RobMeades/watchdog/README.md

The files in this repo are the source files for the watchdog project, details of which can be found here:

https://www.meades.org/misc/watchdog/watchdog.html
