RobMeades/watchdog/blender/README.md

# Introduction
Here are the 3D-printed parts of the watchdog, based on the marvellous [Wallace and Gromit](https://www.thingiverse.com/thing:1852021) model from [reddadsteve](https://www.thingiverse.com/reddadsteve/designs) on [Thingiverse](https://www.thingiverse.com/).  As with the original, all parts are designed to be printed on an FDM printer such as the [Prusa MK4S](https://www.prusa3d.com/product/original-prusa-mk4s-3d-printer-5/), though the parts here are three times larger and rather more complex given the mechanisation.

# Printing Guidelines
I printed all parts except for the two cog wheels in ASA: all of the body parts (body, torso, collar, face and neck) in natural ASA, the ears, nose and black eyes in black ASA.  The white eyes were printed in natural ASA and painted gloss white afterwards.  The board tray can be printed in any colour.  0.2&nbsp;mm print resolution with 10% in-fill is fine, brims and supports everywhere; these are generally large/complex parts.  I used ASA for UV safety, with which you will likely need glue-stick applied to the heat-bed unless you have a heated chamber (I applied glue-stick and also heated the entire room where the printer is housed to 40&nbsp;C for a few days with a space heater), but you could equally well use PLA if you were less concerned about UV safety.

For hardness, the two cog wheels were printed in polycarbonate at 0.2&nbsp;mm print resolution but with 25% in-fill: ASA is bad enough to print, polycarbonate is even worse but the two cog wheels are quite small so I got away with it; no supports but brims and a whole load of glue stick required.  Likely it is not actually critical to use polycarbonate: if you don't have any then you might use ASA for the cog wheels also.

Be careful when removing the support material, particularly around the back of the collar where the cable outlet is quite delicate, and in the nose, where there are deliberate steps in the front surface of the nose that you don't want to remove by accident (but you _do_ want to _remove_ all of the support material to avoid damaging the camera module).  Removing the support material from the sinuous holes behind the eyes is a b\*gger: I found that a judiciously bent knitting needle did the trick.  The in-fill of the M5 and M2 tap holes should be removable without issue and the in-fill of the holes for the 1.5&nbsp;mm brass bar, used for the electrical limit contacts, should come out with the aid of a pin.

# Assembly Instructions
See https://www.meades.org/misc/watchdog/watchdog.html#assembly.
