RobMeades/watchdog/software/play.png

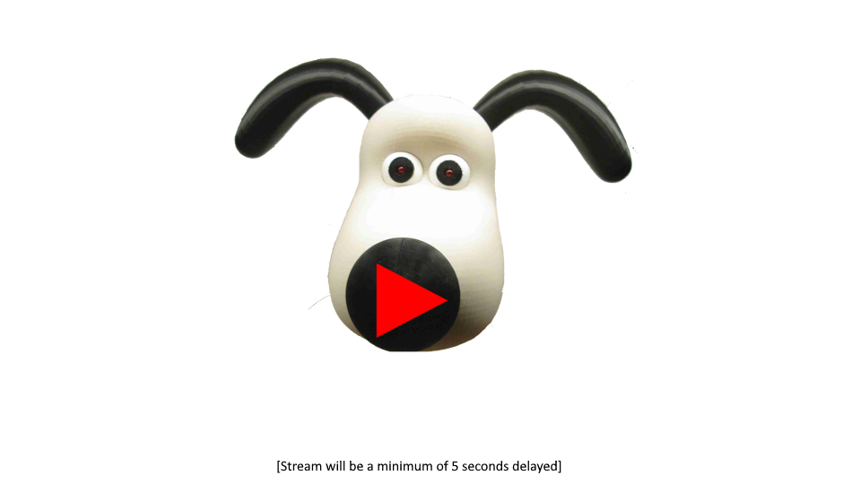
software/play.png
