RobMeades/watchdog/gearotic/pinion.stl

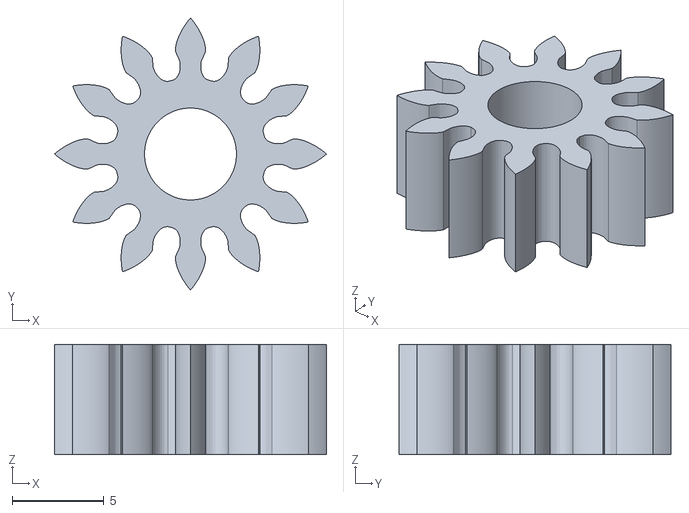
[picture p2: CAD file, 2024-11-27]
gearotic/pinion.stl
14.8 x 14.8 x 6.00
