RobMeades/watchdog/gearotic/wheel.stl

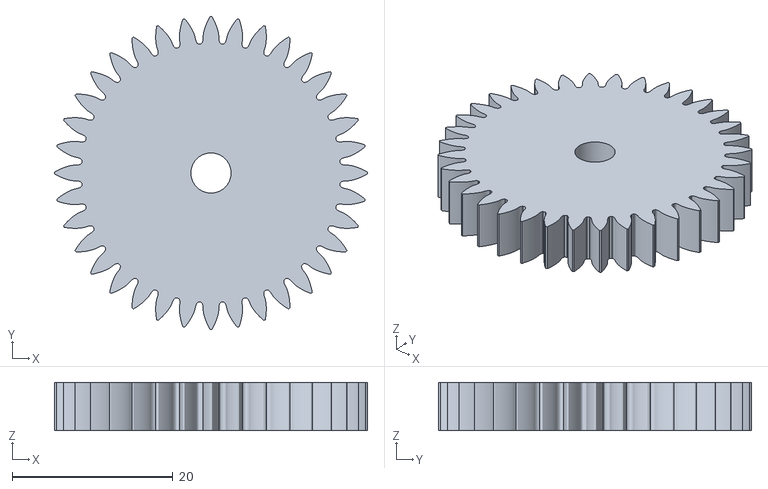
[picture p3: CAD file, 2024-11-27]
gearotic/wheel.stl
39.0 x 39.0 x 6.00
