RobMeades/watchdog/software/w_motor.h

/*
 * Copyright 2025 Rob Meades
 *
 * Licensed under the Apache License, Version 2.0 (the "License");
 * you may not use this file except in compliance with the License.
 * You may obtain a copy of the License at
 *
 * http://www.apache.org/licenses/LICENSE-2.0
 *
 * Unless required by applicable law or agreed to in writing, software
 * distributed under the License is distributed on an "AS IS" BASIS,
 * WITHOUT WARRANTIES OR CONDITIONS OF ANY KIND, either express or implied.
 * See the License for the specific language governing permissions and
 * limitations under the License.
 */

#ifndef _W_MOTOR_H_
#define _W_MOTOR_H_

// This API is dependent on std::string.
#include <string>

/** @file
 * @brief The motor API for the watchdog application; this API is
 * thread-safe.
 */

/* ----------------------------------------------------------------
 * COMPILE-TIME MACROS
 * -------------------------------------------------------------- */

#ifndef W_MOTOR_ROTATE_MAX_STEPS
/** A hard-coded safety limit on the range of rotational movement.
 */
# define W_MOTOR_ROTATE_MAX_STEPS 600
#endif

#ifndef W_MOTOR_VERTICAL_MAX_STEPS
/** A hard-coded safety limit on the range of vertical movement.
 */
# define W_MOTOR_VERTICAL_MAX_STEPS 650
#endif

#ifndef W_MOTOR_ROTATE_DIRECTION_SENSE
/** The direction that a "1" on the rotate motor's direction
 * pin causes the motor to move: -1 since a -1 on the rotate
 * motors direction pin causes it to move towards the maximum,
 * which is W_GPIO_PIN_INPUT_LOOK_RIGHT_LIMIT (otherwise it would
 * need to be 1).
 */
# define W_MOTOR_ROTATE_DIRECTION_SENSE -1
#endif

#ifndef W_MOTOR_VERTICAL_DIRECTION_SENSE
/** The direction that a "1" on the vertical motor's direction
 * pin causes the motor to move: -1 since a -1 on the vertical
 * motors direction pin causes it to move towards the maximum,
 * which is W_GPIO_PIN_INPUT_LOOK_UP_LIMIT (otherwise it would
 * need to be 1).
 */
# define W_MOTOR_VERTICAL_DIRECTION_SENSE -1
#endif

#ifndef W_MOTOR_DIRECTION_WAIT_MS
/** The pause between setting the direction that a step is to
 * take and requesting the step.
 */
# define W_MOTOR_DIRECTION_WAIT_MS 1
#endif

#ifndef W_MOTOR_STEP_WAIT_MS
/** The pause between setting a step pin output low and raising it
 * high again; also the pause between a pin being high and
 * letting it drop again.
 */
# define W_MOTOR_STEP_WAIT_MS 1
#endif

#ifndef W_MOTOR_LIMIT_MARGIN_STEPS
/** How many steps to stay clear of the limit switches in normal
 * operation.
 */
# define W_MOTOR_LIMIT_MARGIN_STEPS 50
#endif

#ifndef W_MOTOR_CALIBRATE_ONE_CALIBRATE_ALL
/** Normally, when a motor is uncalibrated it can be calibrated
 * and the calibration of the other motor is unaffected.  However,
 * it can also be that jarring during the calibration process,
 * which involves hitting the end-stops, cause the calibration of
 * one motor to adversly affect the calibration or the position
 * of the other; set this to true and if one motor falls out of
 * calibration _both_ motors will be calibrated.
 */
# define W_MOTOR_CALIBRATE_ONE_CALIBRATE_ALL true
#endif

/* ----------------------------------------------------------------
 * TYPES
 * -------------------------------------------------------------- */

/** The motor types; values are important as they are the index
 * to that motor in gMotor[].  The motors are calibrated in this
 * order.
 */
typedef enum {
    W_MOTOR_TYPE_VERTICAL = 0,
    W_MOTOR_TYPE_ROTATE = 1,
    W_MOTOR_TYPE_MAX_NUM
} wMotorType_t;

/** Where the motor should sit by default, e.g. after calibration;
 * if you change the order here then you should change
 * gRestPositionStr[] to match.
 */
typedef enum {
    W_MOTOR_REST_POSITION_CENTRE,
    W_MOTOR_REST_POSITION_MAX,
    W_MOTOR_REST_POSITION_MIN
} wMotorRestPosition_t;

/** The definition of a motor.
 */
typedef struct {
    const char *name;
    unsigned int safetyLimit; // Safety limit, must be at least max - min
    int pinDisable; // The pin which when set to 1 disables the motor
    int pinDirection; // The pin which, if set to 1, makes steps * senseDirection positive
    int pinStep;  // The pin which causes the motor to step on a 0 to 1 transition
    int pinMax;   // The pin which, when pulled low, indicates max has been reached
    int pinMin;   // The pin which, when pulled low, indicates min has been reached
    int senseDirection; // 1 if a 1 at pinDirection moves towards max, else -1
    wMotorRestPosition_t restPosition;
    int lastUnitStep; // Needed since Linux doesn't allow the state of an output pin to be read
    int userMax;  // The user-override maximum limit in steps (see wMotorRangeSet())
    int userMin;  // The user-override maximum limit in steps (see wMotorRangeSet())
    int userRestSet; // If true then userRest has meaning
    int userRest;
    bool calibrated; // Ignore the remaining values if this is false
    int max;      // The positive calibrated limit in steps
    int min;      // The negative calibrated limit in steps
    int now;
} wMotor_t;

/* ----------------------------------------------------------------
 * FUNCTIONS
 * -------------------------------------------------------------- */

/** Initialise the motors: THIS WILL CAUSE MOVEMENT, calibrating
 * the movement range of the motors and, if successful, the motors
 * will be enabled on return so that wMotorMove() and wMotorMoveToRest()
 * will both function.  wGpioInit() must have returned successfully
 * before this is called.
 *
 * @param doNotOperateMotors  if true, the motors will not be operated,
 *                            even for calibration; used for debug/
 *                            maintenance only as the API will not
 *                            do anything useful with this flag set.
 * @return                    zero on success else negative error code.
 */
int wMotorInit(bool doNotOperateMotors = false);

/** Try to move the given number of steps, returning the number
 * actually stepped in stepsTaken; being short on steps does not
 * constitute an error.  Will only move if calibrated unless
 * evenIfUnCalibrated is true.
 *
 * For W_MOTOR_TYPE_VERTICAL a positive step moves the watchdog to
 * look upwards, a negative stop to look downwards.
 *
 * For W_MOTOR_TYPE_ROTATE a positive step moves the watchdog to
 * look to the right, a negative step to look to the left.
 *
 * @param type               the motor type to move.
 * @param steps              the number of steps to move the motor.
 * @param stepsTaken         a pointer to a place to put the number
 *                           of steps actually taken; may be nullptr.
 * @param evenIfUnCalibrated if true then the motor will be moved
 *                           even if it is marked as uncalibrated,
 *                           else no steps will be taken if the motor
 *                           is marked as uncalibrated.
 * @return                   zero on success else negative error code.
 */
int wMotorMove(wMotorType_t type, int steps, int *stepsTaken = nullptr,
               bool evenIfUnCalibrated = false);

/** Send a motor to its rest position; will only do so if the motor
 * is calibrated.  Not being able to get to the rest position _does_
 * constitute an error.
 *
 * @param type        the motor type to move.
 * @param stepsTaken  a pointer to a place to put the number of steps
 *                    taken; may be nullptr.
 * @return            zero on success else negative error code.
 */
int wMotorMoveToRest(wMotorType_t type, int *stepsTaken = nullptr);

/** Determine if a motor needs calibration.
 *
 * @param type the motor type.
 * @return     true if the motor needs calibration, else false.
 */
bool wMotorNeedsCalibration(wMotorType_t type);

/** Get the descriptive name of the given motor.
 *
 * @param type the motor type.
 * @return     the motor name; may be an empty string.
 */
std::string wMotorNameGet(wMotorType_t type);

/** Calibrate the movement range of a motor; THIS WILL CAUSE MOVEMENT.
 * If successful then the motor will be marked as calibrated.
 *
 * @param type the motor type to calibrate.
 * @return     zero on success else negative error code.
 */
int wMotorCalibrate(wMotorType_t type);

/** Get the calibrated range of a motor; will return an error if
 * a motor is uncalibrated.  If a user range has been set with
 * wMotorRangeSet() and it is less than the calibrated range
 * then the user range will be reported.
 *
 * @param type the motor type to get the range of.
 * @return     the range in steps else negative error code.
 */
int wMotorRangeGet(wMotorType_t type);

/** Set the range of a motor; this should only be used, e.g.
 * in conjunction with wMotorRangeGet(), to reduce the range
 * of a motor if required.  Should minSteps or maxSteps fall
 * outside of the range of the motor, estalibished during
 * calibration, the value will be ignored.
 *
 * @param type     the motor type to set the range for.
 * @param maxSteps the maximum steps value, a positive offset
 *                 from the central zero established during
 *                 calibration, use zero to remove an existing
 *                 user maximum range setting and allow the
 *                 calibrated value to take over.
 * @param minSteps the minimum steps value, a negative offset
 *                 from the central zero established during
 *                 calibration, use zero to remove an existing
 *                 user minimum range setting and allow the
 *                 calibrated value to take over.
 * @return         zero on success else negative error code.
 */
int wMotorRangeSet(wMotorType_t type, int maxSteps = 0,
                   int minSteps = 0);

/** Set the rest position of a motor; the position is set in
 * steps relative to the centre of the motors calibrated
 * range.  Use wMotorRestReset() to revert the rest position
 * to whatever is the default, removing this setting.
 *
 * @param type  the motor type to set the rest position of.
 * @param steps the rest position in steps; if the value is
 *              outside of the calibrated range it will stop
 *              at the limit, so for instance you could use
 *              INT_MAX or INT_MIN to set the upper or lower
 *              limit to be the rest position; 0 is the centre;
 *              should the motor be re-calibrated the centre
 *              will be trimmed to fit, always getting smaller.
 * @return      zero on success else negative error code.
 */
int wMotorRestSet(wMotorType_t type, int steps);

/** Reset the rest position of a motor to default.
 *
 * @param type  the motor type to reset the rest position of.
 * @return      zero on success else negative error code.
 */
int wMotorRestReset(wMotorType_t type);

/** Deinitialise the motors: this will disable the motors and no
 * movement will be possible until motorInit() is called once
 * more.
 */
void wMotorDeinit();

#endif // _W_MOTOR_H_

// End of file
