RobMeades/watchdog/(commit log)

2024-11-22 Initial version of CPP application: just lists the available cameras at the moment.
2024-11-26 Add first version of 3D print files.
2024-11-27 Add gearotic files and the associated STL output that provide the cogs imported into the Blender model.
    [pinion.stl, wheel.stl]
2024-11-30 Blender model in very close to final form, software moved to CPP, now at a point where the camera is configured to send two streams, one high res for recording and a low res on that we can process as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
2024-12-02 Software now manages to pass a frame to an HLS streaming thingy and, though that doesn't work properly yet, there is at least a sign of a full colour 1920x1080 picture appearing in a .ts file, which 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
    Also a minor update to the blender README.md.
    [watchdog.cpp]
2024-12-05 More WIP on the software front, looking a lot better now though.
    1920/1080 resolution is pushing the poor HW on the PiZero2W a bit too far: when the video encoder has received 45 frames (it needs that many to being its true calculations) it takes 15 to 20 seconds to return with 1920/1080 resolution. Reducing to 854/480 brings the delay at that point down to just over a second, which is survivable.
    Also, advice from JEEB on the #ffmpeg channel of https://web.libera.chat/ pointed me towards a flag one has to add to the AvCodecContext (AV_CODEC_FLAG_FRAME_DURATION), otherwise the frame duration doesn't end up in the codec output and HLS moans that it can't time segments, and a detailed look at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
    [watchdog.cpp]
2024-12-07 Reduce the carrier board height very slightly so that it fits into the mouth.
2024-12-08 Switch resolution to 950x540: at 1920x1080 the frame backlog starts to creep up once the page is being served, while at 950x540 there seems to be no backlog at all. This gives us some room for OpenCV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
2024-12-10 Now detecting motion and drawing what is detected on the stream (in B&W). Main problem is the weirdness with the streaming, in that the client-side only works if I start it before the stream begins; 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
    [watchdog.cpp]
2024-12-10 Finally figured out the obvious/simple way to have the bounding boxes on a colour image. Still have the HLS stream problem though...
    [watchdog.cpp]
2024-12-12 Focus circle added to the logic, and a control loop. Need some electronics now. And fix for the HLS startup issue still.
    [watchdog.cpp]
2024-12-12 D'oh: OpenCV was operating in-place on the DMA memory, I hadn't realised that, the memcpy() was superfluous.
2024-12-12 Blender changes: correction to position of forward torso contact hole and corresponding forward base-upper contact holes so that they work correctly.
2024-12-12 Move image processing out of the requestedCompleted() callback; I have been getting a segmentation fault in the first function I call from the requestCompleted() callback, have raised this with Raspb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
    In case this was down to occupying the requestCompleted() callback, or the DMA buffer, for too long I though it would be sensible to move all my processing out of that function (since I end up taking a copy of the buffer anyway to queue it to the video stream encoder this doesn't really _cost_ anything more).
    It doesn't help, u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
    [watchdog.cpp]
2024-12-13 Fix segmentation fault, all _my_ fault, see explanation at the link I gave in the previous commit. Also stop "using namespace" and just do prefixing as I think it is clearer that way.
    [watchdog.cpp]
2024-12-13 Add command-line options, in readiness for putting the output files on a RAM drive to avoid hitting the SD card so hard when streaming.
    [watchdog.cpp]
2024-12-15 Finally, fixed the issue with the hls.js client not starting unless it was started at exactly the same time as the served stream: One needs to tell the FFmpeg `libx264` video codec to `-tune zerolate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
    Why? I couldn't tell you. It has taken me nearly a week of trying everything I could try before I found this. With this single option added the `hls.js` client synchronizes, and re-synchronizes, with the HLS stream every time, under all circumstances. Without it, `hls.js` will not gain initial sync to a HLS stream if it is started just a few seconds after the stream has begun and, won't regain synchronization if it should lose it.
    I did try running `hls.js` with `lowLatency: false` bu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
    [watchdog.cpp]
2024-12-17 Added all of the infrastructure to read, debounce and write GPIOs (using libgpiod). None of the pin numbers set yet though.
2024-12-18 Add face jig to aid with setting up the wiring.
2024-12-22 Minor updates to free up the shaft of the vertical axis motor.
2024-12-23 Initial version of motor software: calibrates itself and sits nice and centre.
2024-12-24 Make the message loops sleep properly, LED control added, though it doesn't do anything yet.
    [watchdog.cpp]
2024-12-25 LED constant mode tested.
2024-12-26 LED stuff, WIP.
2024-12-29 First phase of moving things out into separate source files: currently util, log, gpio, hls and command_line. Next LED and messaging.
2024-12-29 Motor moved out into its own API; LED and messaging should have been next but LED requires messaging to be done first and messaging needs a bit of a run-up.
2024-12-30 Messaging separated out and improved, LEDs separated out and driven using the new messaging API. The camera, image processing and video stuff is currently #if 0'ed out, will move all of that next.
2024-12-31 Everything now nicely modularised and, as far as I can tell, working. Needs more thrashing though. Also needs the LED bit completing. Then I can create the control thing and see how the watchdog move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
2025-01-02 Add the Morse stuff to the LED code.
2025-01-03 Add LED level scaling and make ramping work correctly.
    [w_led.cpp, w_led.h]
2025-01-03 Tweaks to video encode to bring acceptable encode rate and comment out some of the more excessive debug prints in the image processing.
2025-01-03 Vertical flip camera since it is fitted upside-down for the Pi 5.
    [w_camera.cpp]
2025-01-07 Version to match a slower (= safer) version of the YouTube video behaviour: i.e. the head is moving but the strategy will need to change since it is currently mostly tracking artefacts of its own mot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
2025-01-09 Rather better behaviour: the watchdog's head now waits for movement, moves to point to it and then waits 5 seconds before restarting averaging of motion, resetting to the rest position after 30 secon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
    Also, to work around issues with the way recalibration works, mechanically speaking, W_MOTOR_CALIBRATE_ONE_CALIBRATE_ALL is introduced and set to true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
    [w_control.cpp, w_control.h, w_image_processing.cpp, w_image_processing.h, w_motor.cpp, w_motor.h]
2025-01-12 WIP: added a configuration file that, in future, will be manipulated from the web interface (currently just read and displayed in raw JSON on the web interface). Also added ability to start up withou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
2025-01-16 Reading modified data back from the table that appears correct, next to send...
    [script.js]
2025-01-17 Configuration data appears to be being written to the server successfully, however Apache doesn't change the file; more research needed.
    [script.js]
2025-01-21 C++ code now obeying all of the configuration items, also scheduling its tasks in a real-time fashion nicely.
    Gave up on luxon.js for the humanized display of time on the web interface as it doesn't really do it right (jumps when moving from hours to minutes left etc.), just not as good as moments.js, deprecated or not; now using moments.js. Added highlighting of the current hour to the displayed schedule.
    The software is now cooked aside from debugging of the LED behaviours; over to physical stuff.
    [index.js, w_cfg.cpp, w_cfg.h, w_common.h, w_control.cpp, w_control.h, w_gpio.cpp, w_gpio.h]
2025-01-26 LEDs fixed, use of keepGoing flag fixed, camera rotation fixed (now under #define W_CAMERA_ROTATED_180).
    [w_camera.cpp, w_control.cpp, w_gpio.cpp, w_led.cpp, w_led.h, w_motor.cpp, w_util.cpp]
2025-01-26 Make the LEDs obey the schedule and start watchdog at boot.
2025-01-28 Better fix for previous case and handle case where a thing (motors or lights) doesn't appear in the schedule at all.
    [index.js, w_cfg.cpp]
2025-01-29 Tweaks for operation in a real window: add command-line parameters to permit the rest position, look-limits and continuous movement duration to be set. I run this with a vertical rest position of -70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
    Also have a separate duration for LED ramp-down and set it to 5 seconds in the hope that the watchdog won't retrigger its active state when it sees the reflection of its own eyes ramp down.
    [w_command_line.cpp, w_command_line.h, w_control.cpp, w_control.h, w_image_processing.cpp, w_image_processing.h, w_main.cpp, w_motor.cpp]
2025-02-28 Remove hard-coded path (and conditional compilation flag W_HLS_BASE_URL) of .ts segments in the .m3u8 file; it is not required and it actively prevents video segments from being served correctly to d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
    [w_hls.h, w_video_encode.cpp]
2025-03-06 Move the date/time overlay to the top left to match most other cameras, add "watchdog" as title in index.html so that it is the title of a browser tab, rather than the URL.
2025-03-20 Correct logic of printing defaults in command-line help.
    [w_command_line.cpp]
